ChenBaoW/Foot-wheel-robots/hardware/image/硬件讲解/1720327964392.png

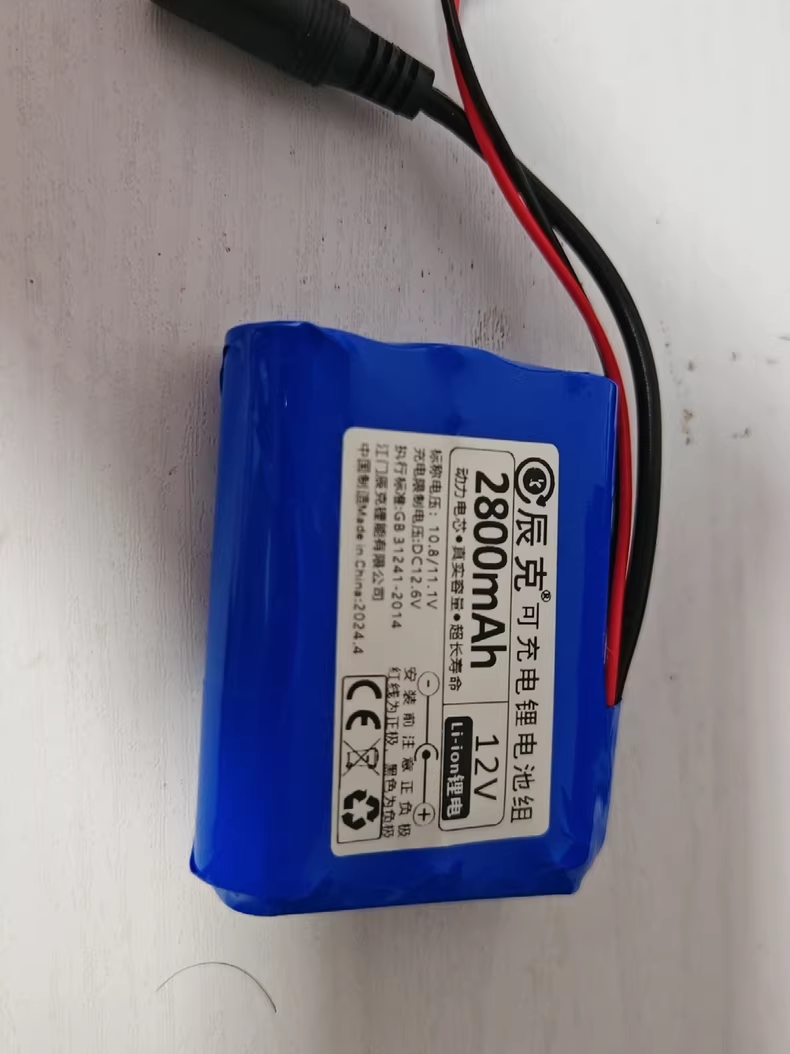
hardware/image/硬件讲解/1720327964392.png
