ChenBaoW/Foot-wheel-robots/mechanical structure/3D文件/镜向右小腿.step

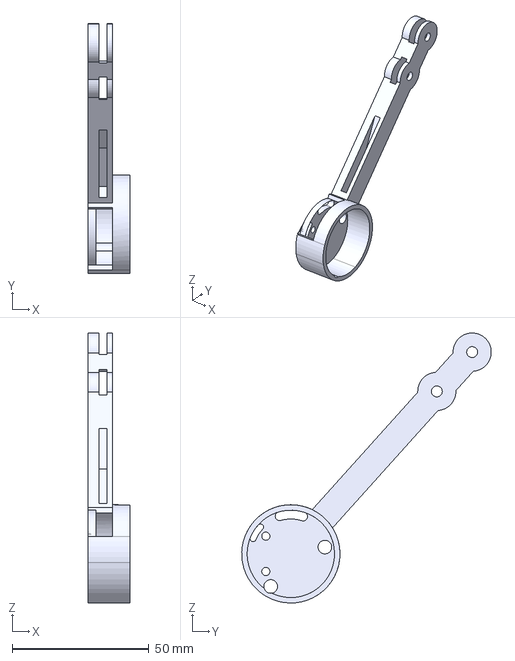
[picture p21: CAD file, 2024-07-05]
mechanical structure/3D文件/镜向右小腿.step
15.5 x 91.4 x 98.9 mm
