ChenBaoW/Foot-wheel-robots/mechanical structure/3D文件/大腿.step

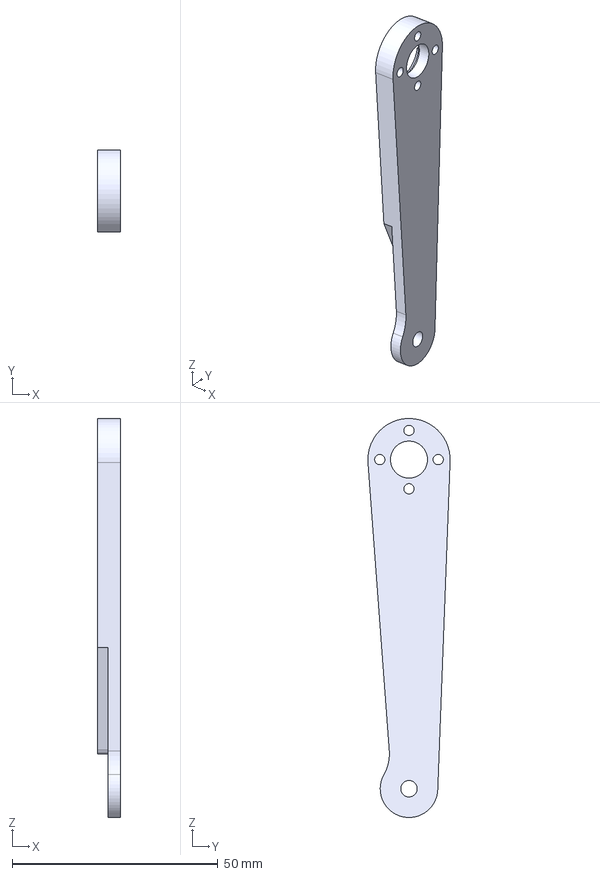
[picture p22: CAD file, 2024-07-05]
mechanical structure/3D文件/大腿.step
5.50 x 20.0 x 97.0 mm
