ChenBaoW/Foot-wheel-robots/mechanical structure/3D文件/镜向副腿.step

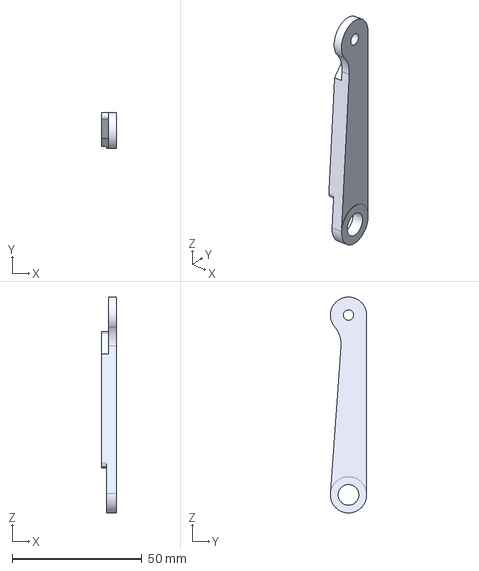
[picture p23: CAD file, 2024-07-05]
mechanical structure/3D文件/镜向副腿.step
5.95 x 14.0 x 83.4 mm
