ChenBaoW/Foot-wheel-robots/mechanical structure/3D文件/前支撑(带电池夹) .step

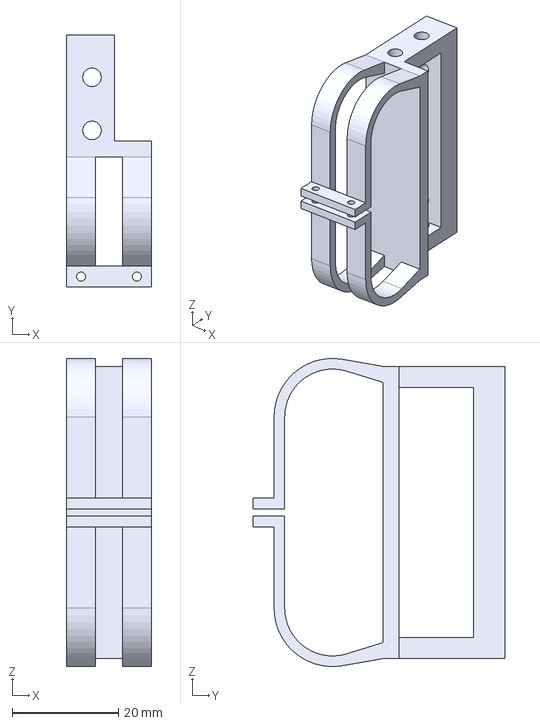
[picture p24: CAD file, 2024-07-05]
mechanical structure/3D文件/前支撑(带电池夹) .step
16.0 x 47.5 x 58.0 mm
