ChenBaoW/Foot-wheel-robots/mechanical structure/3D文件/后支撑.step

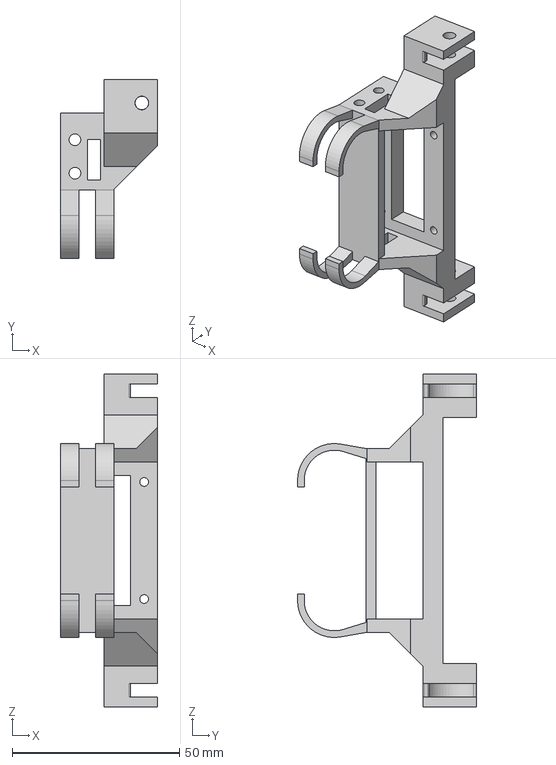
[picture p25: CAD file, 2024-07-05]
mechanical structure/3D文件/后支撑.step
29.0 x 53.5 x 99.6 mm
