ChenBaoW/Foot-wheel-robots/(list of files, cad)

Other CAD files:
mechanical structure/3D文件/副腿.step
mechanical structure/3D文件/镜向大腿.step
mechanical structure/3D文件/前支撑(带电池夹)_.f3d
mechanical structure/3D文件/副腿.f3d
mechanical structure/3D文件/右小腿.f3d
mechanical structure/3D文件/后支撑.f3d
mechanical structure/3D文件/后支撑.ipt
mechanical structure/3D文件/大腿.f3d
mechanical structure/3D文件/大腿.stl
mechanical structure/3D文件/镜向副腿.f3d
mechanical structure/3D文件/镜向右小腿.f3d
mechanical structure/3D文件/镜向大腿.f3d
