ChenBaoW/Foot-wheel-robots/software/4_closeloop_M1_test/4_closeloop_M1/Objects/motor.htm

# Static Call Graph for image .\Objects\motor.axf

#<CALLGRAPH># ARM Linker, 5060960: Last Updated: Thu Apr 11 21:01:33 2024

### Maximum Stack Usage = 352 bytes + Unknown(Cycles, Untraceable Function Pointers)

### Call chain for Maximum Stack Depth:

main ⇒ Motor_initFOC ⇒ alignSensor ⇒ setPhaseVoltage ⇒ atan2 ⇒ atan ⇒ __kernel_poly ⇒ __aeabi_dmul ⇒ _double_epilogue ⇒ _double_round

### Mutually Recursive functions

- ADC1_2_IRQHandler ⇒ ADC1_2_IRQHandler

### Function Pointers

- ADC1_2_IRQHandler from startup_stm32f10x_md.o(.text) referenced from startup_stm32f10x_md.o(RESET)
- BusFault_Handler from stm32f10x_it.o(i.BusFault_Handler) referenced from startup_stm32f10x_md.o(RESET)
- CAN1_RX1_IRQHandler from startup_stm32f10x_md.o(.text) referenced from startup_stm32f10x_md.o(RESET)
- CAN1_SCE_IRQHandler from startup_stm32f10x_md.o(.text) referenced from startup_stm32f10x_md.o(RESET)
- DMA1_Channel1_IRQHandler from startup_stm32f10x_md.o(.text) referenced from startup_stm32f10x_md.o(RESET)
- DMA1_Channel2_IRQHandler from startup_stm32f10x_md.o(.text) referenced from startup_stm32f10x_md.o(RESET)
- DMA1_Channel3_IRQHandler from startup_stm32f10x_md.o(.text) referenced from startup_stm32f10x_md.o(RESET)
- DMA1_Channel4_IRQHandler from startup_stm32f10x_md.o(.text) referenced from startup_stm32f10x_md.o(RESET)
- DMA1_Channel5_IRQHandler from startup_stm32f10x_md.o(.text) referenced from startup_stm32f10x_md.o(RESET)
- DMA1_Channel6_IRQHandler from startup_stm32f10x_md.o(.text) referenced from startup_stm32f10x_md.o(RESET)
- DMA1_Channel7_IRQHandler from startup_stm32f10x_md.o(.text) referenced from startup_stm32f10x_md.o(RESET)
- DebugMon_Handler from stm32f10x_it.o(i.DebugMon_Handler) referenced from startup_stm32f10x_md.o(RESET)
- EXTI0_IRQHandler from startup_stm32f10x_md.o(.text) referenced from startup_stm32f10x_md.o(RESET)
- EXTI15_10_IRQHandler from startup_stm32f10x_md.o(.text) referenced from startup_stm32f10x_md.o(RESET)
- EXTI1_IRQHandler from startup_stm32f10x_md.o(.text) referenced from startup_stm32f10x_md.o(RESET)
- EXTI2_IRQHandler from startup_stm32f10x_md.o(.text) referenced from startup_stm32f10x_md.o(RESET)
- EXTI3_IRQHandler from startup_stm32f10x_md.o(.text) referenced from startup_stm32f10x_md.o(RESET)
- EXTI4_IRQHandler from startup_stm32f10x_md.o(.text) referenced from startup_stm32f10x_md.o(RESET)
- EXTI9_5_IRQHandler from startup_stm32f10x_md.o(.text) referenced from startup_stm32f10x_md.o(RESET)
- FLASH_IRQHandler from startup_stm32f10x_md.o(.text) referenced from startup_stm32f10x_md.o(RESET)
- HardFault_Handler from stm32f10x_it.o(i.HardFault_Handler) referenced from startup_stm32f10x_md.o(RESET)
- I2C1_ER_IRQHandler from startup_stm32f10x_md.o(.text) referenced from startup_stm32f10x_md.o(RESET)
- I2C1_EV_IRQHandler from startup_stm32f10x_md.o(.text) referenced from startup_stm32f10x_md.o(RESET)
- I2C2_ER_IRQHandler from startup_stm32f10x_md.o(.text) referenced from startup_stm32f10x_md.o(RESET)
- I2C2_EV_IRQHandler from startup_stm32f10x_md.o(.text) referenced from startup_stm32f10x_md.o(RESET)
- MemManage_Handler from stm32f10x_it.o(i.MemManage_Handler) referenced from startup_stm32f10x_md.o(RESET)
- NMI_Handler from stm32f10x_it.o(i.NMI_Handler) referenced from startup_stm32f10x_md.o(RESET)
- PVD_IRQHandler from startup_stm32f10x_md.o(.text) referenced from startup_stm32f10x_md.o(RESET)
- PendSV_Handler from stm32f10x_it.o(i.PendSV_Handler) referenced from startup_stm32f10x_md.o(RESET)
- RCC_IRQHandler from startup_stm32f10x_md.o(.text) referenced from startup_stm32f10x_md.o(RESET)
- RTCAlarm_IRQHandler from startup_stm32f10x_md.o(.text) referenced from startup_stm32f10x_md.o(RESET)
- RTC_IRQHandler from startup_stm32f10x_md.o(.text) referenced from startup_stm32f10x_md.o(RESET)
- Reset_Handler from startup_stm32f10x_md.o(.text) referenced from startup_stm32f10x_md.o(RESET)
- SPI1_IRQHandler from startup_stm32f10x_md.o(.text) referenced from startup_stm32f10x_md.o(RESET)
- SPI2_IRQHandler from startup_stm32f10x_md.o(.text) referenced from startup_stm32f10x_md.o(RESET)
- SVC_Handler from stm32f10x_it.o(i.SVC_Handler) referenced from startup_stm32f10x_md.o(RESET)
- SysTick_Handler from stm32f10x_it.o(i.SysTick_Handler) referenced from startup_stm32f10x_md.o(RESET)
- SystemInit from system_stm32f10x.o(i.SystemInit) referenced from startup_stm32f10x_md.o(.text)
- TAMPER_IRQHandler from startup_stm32f10x_md.o(.text) referenced from startup_stm32f10x_md.o(RESET)
- TIM1_BRK_IRQHandler from startup_stm32f10x_md.o(.text) referenced from startup_stm32f10x_md.o(RESET)
- TIM1_CC_IRQHandler from startup_stm32f10x_md.o(.text) referenced from startup_stm32f10x_md.o(RESET)
- TIM1_TRG_COM_IRQHandler from startup_stm32f10x_md.o(.text) referenced from startup_stm32f10x_md.o(RESET)
- TIM1_UP_IRQHandler from startup_stm32f10x_md.o(.text) referenced from startup_stm32f10x_md.o(RESET)
- TIM2_IRQHandler from startup_stm32f10x_md.o(.text) referenced from startup_stm32f10x_md.o(RESET)
- TIM3_IRQHandler from startup_stm32f10x_md.o(.text) referenced from startup_stm32f10x_md.o(RESET)
- TIM4_IRQHandler from stm32f10x_it.o(i.TIM4_IRQHandler) referenced from startup_stm32f10x_md.o(RESET)
- USART1_IRQHandler from usart.o(i.USART1_IRQHandler) referenced from startup_stm32f10x_md.o(RESET)
- USART2_IRQHandler from startup_stm32f10x_md.o(.text) referenced from startup_stm32f10x_md.o(RESET)
- USART3_IRQHandler from startup_stm32f10x_md.o(.text) referenced from startup_stm32f10x_md.o(RESET)
- USBWakeUp_IRQHandler from startup_stm32f10x_md.o(.text) referenced from startup_stm32f10x_md.o(RESET)
- USB_HP_CAN1_TX_IRQHandler from startup_stm32f10x_md.o(.text) referenced from startup_stm32f10x_md.o(RESET)
- USB_LP_CAN1_RX0_IRQHandler from startup_stm32f10x_md.o(.text) referenced from startup_stm32f10x_md.o(RESET)
- UsageFault_Handler from stm32f10x_it.o(i.UsageFault_Handler) referenced from startup_stm32f10x_md.o(RESET)
- WWDG_IRQHandler from startup_stm32f10x_md.o(.text) referenced from startup_stm32f10x_md.o(RESET)
- __main from entry.o(.ARM.Collect$$$$00000000) referenced from startup_stm32f10x_md.o(.text)
- _sbackspace from _sgetc.o(.text) referenced from strtod.o(.text)
- _sgetc from _sgetc.o(.text) referenced from strtod.o(.text)
- fputc from usart.o(i.fputc) referenced from printfb.o(i.__0printf$bare)
- isspace from isspace_c.o(.text) referenced from strtod.o(.text)
- main from main.o(i.main) referenced from entry9a.o(.ARM.Collect$$$$0000000B)

### Global Symbols

__main (Thumb, 0 bytes, Stack size unknown bytes, entry.o(.ARM.Collect$$$$00000000))
[Address Reference Count : 1]

- startup_stm32f10x_md.o(.text)

_main_stk (Thumb, 0 bytes, Stack size unknown bytes, entry2.o(.ARM.Collect$$$$00000001))

_main_scatterload (Thumb, 0 bytes, Stack size unknown bytes, entry5.o(.ARM.Collect$$$$00000004))

[Calls]

- >> __scatterload

__main_after_scatterload (Thumb, 0 bytes, Stack size unknown bytes, entry5.o(.ARM.Collect$$$$00000004))

[Called By]

- >> __scatterload

_main_clock (Thumb, 0 bytes, Stack size unknown bytes, entry7b.o(.ARM.Collect$$$$00000008))

_main_cpp_init (Thumb, 0 bytes, Stack size unknown bytes, entry8b.o(.ARM.Collect$$$$0000000A))

_main_init (Thumb, 0 bytes, Stack size unknown bytes, entry9a.o(.ARM.Collect$$$$0000000B))

__rt_lib_shutdown_fini (Thumb, 0 bytes, Stack size unknown bytes, entry12b.o(.ARM.Collect$$$$0000000E))

__rt_final_cpp (Thumb, 0 bytes, Stack size unknown bytes, entry10a.o(.ARM.Collect$$$$0000000F))

__rt_final_exit (Thumb, 0 bytes, Stack size unknown bytes, entry11a.o(.ARM.Collect$$$$00000011))

Reset_Handler (Thumb, 8 bytes, Stack size 0 bytes, startup_stm32f10x_md.o(.text))
[Address Reference Count : 1]

- startup_stm32f10x_md.o(RESET)

ADC1_2_IRQHandler (Thumb, 0 bytes, Stack size 0 bytes, startup_stm32f10x_md.o(.text))

[Calls]

- >> ADC1_2_IRQHandler

[Called By]

- >> ADC1_2_IRQHandler

[Address Reference Count : 1]

- startup_stm32f10x_md.o(RESET)

CAN1_RX1_IRQHandler (Thumb, 0 bytes, Stack size 0 bytes, startup_stm32f10x_md.o(.text))
[Address Reference Count : 1]

- startup_stm32f10x_md.o(RESET)

CAN1_SCE_IRQHandler (Thumb, 0 bytes, Stack size 0 bytes, startup_stm32f10x_md.o(.text))
[Address Reference Count : 1]

- startup_stm32f10x_md.o(RESET)

DMA1_Channel1_IRQHandler (Thumb, 0 bytes, Stack size 0 bytes, startup_stm32f10x_md.o(.text))
[Address Reference Count : 1]

- startup_stm32f10x_md.o(RESET)

DMA1_Channel2_IRQHandler (Thumb, 0 bytes, Stack size 0 bytes, startup_stm32f10x_md.o(.text))
[Address Reference Count : 1]

- startup_stm32f10x_md.o(RESET)

DMA1_Channel3_IRQHandler (Thumb, 0 bytes, Stack size 0 bytes, startup_stm32f10x_md.o(.text))
[Address Reference Count : 1]

- startup_stm32f10x_md.o(RESET)

DMA1_Channel4_IRQHandler (Thumb, 0 bytes, Stack size 0 bytes, startup_stm32f10x_md.o(.text))
[Address Reference Count : 1]

- startup_stm32f10x_md.o(RESET)

DMA1_Channel5_IRQHandler (Thumb, 0 bytes, Stack size 0 bytes, startup_stm32f10x_md.o(.text))
[Address Reference Count : 1]

- startup_stm32f10x_md.o(RESET)

DMA1_Channel6_IRQHandler (Thumb, 0 bytes, Stack size 0 bytes, startup_stm32f10x_md.o(.text))
[Address Reference Count : 1]

- startup_stm32f10x_md.o(RESET)

DMA1_Channel7_IRQHandler (Thumb, 0 bytes, Stack size 0 bytes, startup_stm32f10x_md.o(.text))
[Address Reference Count : 1]

- startup_stm32f10x_md.o(RESET)

EXTI0_IRQHandler (Thumb, 0 bytes, Stack size 0 bytes, startup_stm32f10x_md.o(.text))
[Address Reference Count : 1]

- startup_stm32f10x_md.o(RESET)

EXTI15_10_IRQHandler (Thumb, 0 bytes, Stack size 0 bytes, startup_stm32f10x_md.o(.text))
[Address Reference Count : 1]

- startup_stm32f10x_md.o(RESET)

EXTI1_IRQHandler (Thumb, 0 bytes, Stack size 0 bytes, startup_stm32f10x_md.o(.text))
[Address Reference Count : 1]

- startup_stm32f10x_md.o(RESET)

EXTI2_IRQHandler (Thumb, 0 bytes, Stack size 0 bytes, startup_stm32f10x_md.o(.text))
[Address Reference Count : 1]

- startup_stm32f10x_md.o(RESET)

EXTI3_IRQHandler (Thumb, 0 bytes, Stack size 0 bytes, startup_stm32f10x_md.o(.text))
[Address Reference Count : 1]

- startup_stm32f10x_md.o(RESET)

EXTI4_IRQHandler (Thumb, 0 bytes, Stack size 0 bytes, startup_stm32f10x_md.o(.text))
[Address Reference Count : 1]

- startup_stm32f10x_md.o(RESET)

EXTI9_5_IRQHandler (Thumb, 0 bytes, Stack size 0 bytes, startup_stm32f10x_md.o(.text))
[Address Reference Count : 1]

- startup_stm32f10x_md.o(RESET)

FLASH_IRQHandler (Thumb, 0 bytes, Stack size 0 bytes, startup_stm32f10x_md.o(.text))
[Address Reference Count : 1]

- startup_stm32f10x_md.o(RESET)

I2C1_ER_IRQHandler (Thumb, 0 bytes, Stack size 0 bytes, startup_stm32f10x_md.o(.text))
[Address Reference Count : 1]

- startup_stm32f10x_md.o(RESET)

I2C1_EV_IRQHandler (Thumb, 0 bytes, Stack size 0 bytes, startup_stm32f10x_md.o(.text))
[Address Reference Count : 1]

- startup_stm32f10x_md.o(RESET)

I2C2_ER_IRQHandler (Thumb, 0 bytes, Stack size 0 bytes, startup_stm32f10x_md.o(.text))
[Address Reference Count : 1]

- startup_stm32f10x_md.o(RESET)

I2C2_EV_IRQHandler (Thumb, 0 bytes, Stack size 0 bytes, startup_stm32f10x_md.o(.text))
[Address Reference Count : 1]

- startup_stm32f10x_md.o(RESET)

PVD_IRQHandler (Thumb, 0 bytes, Stack size 0 bytes, startup_stm32f10x_md.o(.text))
[Address Reference Count : 1]

- startup_stm32f10x_md.o(RESET)

RCC_IRQHandler (Thumb, 0 bytes, Stack size 0 bytes, startup_stm32f10x_md.o(.text))
[Address Reference Count : 1]

- startup_stm32f10x_md.o(RESET)

RTCAlarm_IRQHandler (Thumb, 0 bytes, Stack size 0 bytes, startup_stm32f10x_md.o(.text))
[Address Reference Count : 1]

- startup_stm32f10x_md.o(RESET)

RTC_IRQHandler (Thumb, 0 bytes, Stack size 0 bytes, startup_stm32f10x_md.o(.text))
[Address Reference Count : 1]

- startup_stm32f10x_md.o(RESET)

SPI1_IRQHandler (Thumb, 0 bytes, Stack size 0 bytes, startup_stm32f10x_md.o(.text))
[Address Reference Count : 1]

- startup_stm32f10x_md.o(RESET)

SPI2_IRQHandler (Thumb, 0 bytes, Stack size 0 bytes, startup_stm32f10x_md.o(.text))
[Address Reference Count : 1]

- startup_stm32f10x_md.o(RESET)

TAMPER_IRQHandler (Thumb, 0 bytes, Stack size 0 bytes, startup_stm32f10x_md.o(.text))
[Address Reference Count : 1]

- startup_stm32f10x_md.o(RESET)

TIM1_BRK_IRQHandler (Thumb, 0 bytes, Stack size 0 bytes, startup_stm32f10x_md.o(.text))
[Address Reference Count : 1]

- startup_stm32f10x_md.o(RESET)

TIM1_CC_IRQHandler (Thumb, 0 bytes, Stack size 0 bytes, startup_stm32f10x_md.o(.text))
[Address Reference Count : 1]

- startup_stm32f10x_md.o(RESET)

TIM1_TRG_COM_IRQHandler (Thumb, 0 bytes, Stack size 0 bytes, startup_stm32f10x_md.o(.text))
[Address Reference Count : 1]

- startup_stm32f10x_md.o(RESET)

TIM1_UP_IRQHandler (Thumb, 0 bytes, Stack size 0 bytes, startup_stm32f10x_md.o(.text))
[Address Reference Count : 1]

- startup_stm32f10x_md.o(RESET)

TIM2_IRQHandler (Thumb, 0 bytes, Stack size 0 bytes, startup_stm32f10x_md.o(.text))
[Address Reference Count : 1]

- startup_stm32f10x_md.o(RESET)

TIM3_IRQHandler (Thumb, 0 bytes, Stack size 0 bytes, startup_stm32f10x_md.o(.text))
[Address Reference Count : 1]

- startup_stm32f10x_md.o(RESET)

USART2_IRQHandler (Thumb, 0 bytes, Stack size 0 bytes, startup_stm32f10x_md.o(.text))
[Address Reference Count : 1]

- startup_stm32f10x_md.o(RESET)

USART3_IRQHandler (Thumb, 0 bytes, Stack size 0 bytes, startup_stm32f10x_md.o(.text))
[Address Reference Count : 1]

- startup_stm32f10x_md.o(RESET)

USBWakeUp_IRQHandler (Thumb, 0 bytes, Stack size 0 bytes, startup_stm32f10x_md.o(.text))
[Address Reference Count : 1]

- startup_stm32f10x_md.o(RESET)

USB_HP_CAN1_TX_IRQHandler (Thumb, 0 bytes, Stack size 0 bytes, startup_stm32f10x_md.o(.text))
[Address Reference Count : 1]

- startup_stm32f10x_md.o(RESET)

USB_LP_CAN1_RX0_IRQHandler (Thumb, 0 bytes, Stack size 0 bytes, startup_stm32f10x_md.o(.text))
[Address Reference Count : 1]

- startup_stm32f10x_md.o(RESET)

WWDG_IRQHandler (Thumb, 0 bytes, Stack size 0 bytes, startup_stm32f10x_md.o(.text))
[Address Reference Count : 1]

- startup_stm32f10x_md.o(RESET)

__aeabi_fadd (Thumb, 164 bytes, Stack size 16 bytes, fadd.o(.text))

[Stack]

- Max Depth = 20
- Call Chain = __aeabi_fadd ⇒ _float_epilogue

[Calls]

- >> _float_round
- >> _float_epilogue

[Called By]

- >> __aeabi_frsub
- >> setPhaseVoltage
- >> __aeabi_fsub
- >> electricalAngle

__aeabi_fsub (Thumb, 6 bytes, Stack size 0 bytes, fadd.o(.text))

[Stack]

- Max Depth = 20
- Call Chain = __aeabi_fsub ⇒ __aeabi_fadd ⇒ _float_epilogue

[Calls]

- >> __aeabi_fadd

[Called By]

- >> setPhaseVoltage
- >> getVelocity
- >> shaftAngle
- >> electricalAngle

__aeabi_frsub (Thumb, 6 bytes, Stack size 0 bytes, fadd.o(.text))

[Stack]

- Max Depth = 20
- Call Chain = __aeabi_frsub ⇒ __aeabi_fadd ⇒ _float_epilogue

[Calls]

- >> __aeabi_fadd

[Called By]

- >> getAngle

__aeabi_fmul (Thumb, 100 bytes, Stack size 8 bytes, fmul.o(.text))

[Stack]

- Max Depth = 8
- Call Chain = __aeabi_fmul

[Called By]

- >> setPhaseVoltage
- >> alignSensor
- >> shaftVelocity
- >> shaftAngle
- >> electricalAngle
- >> _sqrtApprox
- >> _electricalAngle

__aeabi_fdiv (Thumb, 124 bytes, Stack size 8 bytes, fdiv.o(.text))

[Stack]

- Max Depth = 8
- Call Chain = __aeabi_fdiv

[Calls]

- >> _float_round

[Called By]

- >> setPhaseVoltage
- >> getVelocity
- >> getAngle

__aeabi_dadd (Thumb, 322 bytes, Stack size 48 bytes, dadd.o(.text))

[Stack]

- Max Depth = 88
- Call Chain = __aeabi_dadd ⇒ _double_epilogue ⇒ _double_round

[Calls]

- >> __aeabi_lasr
- >> __aeabi_llsl
- >> _double_round
- >> _double_epilogue

[Called By]

- >> __aeabi_drsub
- >> setPhaseVoltage
- >> getAngle
- >> LPF_velocity
- >> __aeabi_dsub
- >> _sin
- >> _normalizeAngle
- >> __kernel_poly
- >> __mathlib_dbl_infnan2
- >> atan

__aeabi_dsub (Thumb, 6 bytes, Stack size 0 bytes, dadd.o(.text))

[Stack]

- Max Depth = 88
- Call Chain = __aeabi_dsub ⇒ __aeabi_dadd ⇒ _double_epilogue ⇒ _double_round

[Calls]

- >> __aeabi_dadd

[Called By]

- >> atan2
- >> setPhaseVoltage
- >> _sin
- >> atan

__aeabi_drsub (Thumb, 6 bytes, Stack size 0 bytes, dadd.o(.text))

[Stack]

- Max Depth = 88
- Call Chain = __aeabi_drsub ⇒ __aeabi_dadd ⇒ _double_epilogue ⇒ _double_round

[Calls]

- >> __aeabi_dadd

[Called By]

- >> fmod
- >> atan2
- >> atan

__aeabi_dmul (Thumb, 228 bytes, Stack size 48 bytes, dmul.o(.text))

[Stack]

- Max Depth = 88
- Call Chain = __aeabi_dmul ⇒ _double_epilogue ⇒ _double_round

[Calls]

- >> _double_epilogue

[Called By]

- >> setPhaseVoltage
- >> getVelocity
- >> getAngle
- >> LPF_velocity
- >> _sin
- >> _fp_value
- >> __kernel_poly
- >> atan

__aeabi_ddiv (Thumb, 222 bytes, Stack size 32 bytes, ddiv.o(.text))

[Stack]

- Max Depth = 40
- Call Chain = __aeabi_ddiv ⇒ _double_round

[Calls]

- >> _double_round

[Called By]

- >> atan2
- >> setPhaseVoltage
- >> _fp_value
- >> __mathlib_dbl_invalid
- >> atan

__aeabi_i2f (Thumb, 18 bytes, Stack size 0 bytes, fflti.o(.text))

[Stack]

- Max Depth = 4
- Call Chain = __aeabi_i2f ⇒ _float_epilogue

[Calls]

- >> _float_epilogue

[Called By]

- >> alignSensor
- >> getAngle
- >> shaftVelocity
- >> shaftAngle
- >> electricalAngle
- >> _electricalAngle

__aeabi_ui2f (Thumb, 10 bytes, Stack size 0 bytes, ffltui.o(.text))

[Stack]

- Max Depth = 4
- Call Chain = __aeabi_ui2f ⇒ _float_epilogue

[Calls]

- >> _float_epilogue

[Called By]

- >> getVelocity
- >> getAngle

__aeabi_i2d (Thumb, 34 bytes, Stack size 16 bytes, dflti.o(.text))

[Stack]

- Max Depth = 56
- Call Chain = __aeabi_i2d ⇒ _double_epilogue ⇒ _double_round

[Calls]

- >> _double_epilogue

[Called By]

- >> getAngle
- >> _sin

__aeabi_ui2d (Thumb, 26 bytes, Stack size 16 bytes, dfltui.o(.text))

[Stack]

- Max Depth = 56
- Call Chain = __aeabi_ui2d ⇒ _double_epilogue ⇒ _double_round

[Calls]

- >> _double_epilogue

[Called By]

- >> setPhaseVoltage

__aeabi_f2iz (Thumb, 50 bytes, Stack size 0 bytes, ffixi.o(.text))

[Called By]

- >> getAngle

__aeabi_f2uiz (Thumb, 40 bytes, Stack size 0 bytes, ffixui.o(.text))

[Called By]

- >> setPhaseVoltage

__aeabi_d2iz (Thumb, 62 bytes, Stack size 16 bytes, dfixi.o(.text))

[Stack]

- Max Depth = 16
- Call Chain = __aeabi_d2iz

[Calls]

- >> __aeabi_llsr

[Called By]

- >> _sin

__aeabi_d2uiz (Thumb, 50 bytes, Stack size 8 bytes, dfixui.o(.text))

[Stack]

- Max Depth = 8
- Call Chain = __aeabi_d2uiz

[Calls]

- >> __aeabi_llsr

[Called By]

- >> setPhaseVoltage

__aeabi_f2d (Thumb, 38 bytes, Stack size 0 bytes, f2d.o(.text))

[Called By]

- >> setPhaseVoltage
- >> getVelocity
- >> getAngle
- >> LPF_velocity
- >> _sin
- >> _normalizeAngle

__aeabi_cdcmpeq (Thumb, 0 bytes, Stack size 0 bytes, cdcmple.o(.text))

[Called By]

- >> atan2

__aeabi_cdcmple (Thumb, 48 bytes, Stack size 0 bytes, cdcmple.o(.text))

[Called By]

- >> setPhaseVoltage
- >> _sin

__aeabi_cdrcmple (Thumb, 48 bytes, Stack size 0 bytes, cdrcmple.o(.text))

[Called By]

- >> setPhaseVoltage
- >> getVelocity
- >> getAngle
- >> _sin

__aeabi_d2f (Thumb, 56 bytes, Stack size 8 bytes, d2f.o(.text))

[Stack]

- Max Depth = 8
- Call Chain = __aeabi_d2f

[Calls]

- >> _float_round

[Called By]

- >> commander_run
- >> setPhaseVoltage
- >> getVelocity
- >> getAngle
- >> LPF_velocity
- >> _sin
- >> _normalizeAngle
- >> _scanf_really_real

__aeabi_cfcmpeq (Thumb, 0 bytes, Stack size 0 bytes, cfcmple.o(.text))

[Called By]

- >> setPhaseVoltage
- >> getVelocity

__aeabi_cfcmple (Thumb, 20 bytes, Stack size 0 bytes, cfcmple.o(.text), UNUSED)

__aeabi_cfrcmple (Thumb, 20 bytes, Stack size 0 bytes, cfrcmple.o(.text))

[Called By]

- >> Motor_init
- >> getAngle
- >> _normalizeAngle

__aeabi_llsl (Thumb, 30 bytes, Stack size 0 bytes, llshl.o(.text))

[Called By]

- >> __aeabi_dadd
- >> _double_epilogue

_ll_shift_l (Thumb, 0 bytes, Stack size 0 bytes, llshl.o(.text), UNUSED)

__aeabi_llsr (Thumb, 32 bytes, Stack size 0 bytes, llushr.o(.text))

[Called By]

- >> __aeabi_d2uiz
- >> __aeabi_d2iz
- >> _double_epilogue

_ll_ushift_r (Thumb, 0 bytes, Stack size 0 bytes, llushr.o(.text), UNUSED)

__aeabi_lasr (Thumb, 36 bytes, Stack size 0 bytes, llsshr.o(.text))

[Called By]

- >> __aeabi_dadd

_ll_sshift_r (Thumb, 0 bytes, Stack size 0 bytes, llsshr.o(.text), UNUSED)

__strtod_int (Thumb, 90 bytes, Stack size 40 bytes, strtod.o(.text))

[Stack]

- Max Depth = 200
- Call Chain = __strtod_int ⇒ _local_sscanf ⇒ _scanf_real

[Calls]

- >> _local_sscanf

[Called By]

- >> atof

__I$use$fp (Thumb, 0 bytes, Stack size 0 bytes, iusefp.o(.text), UNUSED)

_float_round (Thumb, 18 bytes, Stack size 0 bytes, fepilogue.o(.text))

[Called By]

- >> __aeabi_fdiv
- >> __aeabi_fadd
- >> __aeabi_d2f

_float_epilogue (Thumb, 92 bytes, Stack size 4 bytes, fepilogue.o(.text))

[Stack]

- Max Depth = 4
- Call Chain = _float_epilogue

[Called By]

- >> __aeabi_ui2f
- >> __aeabi_fadd
- >> __aeabi_i2f

_double_round (Thumb, 30 bytes, Stack size 8 bytes, depilogue.o(.text))

[Stack]

- Max Depth = 8
- Call Chain = _double_round

[Called By]

- >> __aeabi_ddiv
- >> __aeabi_dadd
- >> _double_epilogue

_double_epilogue (Thumb, 156 bytes, Stack size 32 bytes, depilogue.o(.text))

[Stack]

- Max Depth = 40
- Call Chain = _double_epilogue ⇒ _double_round

[Calls]

- >> __aeabi_llsr
- >> __aeabi_llsl
- >> _double_round

[Called By]

- >> _drem
- >> __aeabi_ui2d
- >> __aeabi_i2d
- >> __aeabi_dmul
- >> __aeabi_dadd
- >> __aeabi_ul2d

_drem (Thumb, 134 bytes, Stack size 48 bytes, drem.o(.text))

[Stack]

- Max Depth = 88
- Call Chain = _drem ⇒ _double_epilogue ⇒ _double_round

[Calls]

- >> _double_epilogue

[Called By]

- >> fmod

__scatterload (Thumb, 28 bytes, Stack size 0 bytes, init.o(.text))

[Calls]

- >> __main_after_scatterload

[Called By]

- >> _main_scatterload

__scatterload_rt2 (Thumb, 0 bytes, Stack size 0 bytes, init.o(.text), UNUSED)

isspace (Thumb, 10 bytes, Stack size 0 bytes, isspace_c.o(.text))

[Calls]

- >> __ctype_lookup

[Address Reference Count : 1]

- strtod.o(.text)

_scanf_real (Thumb, 0 bytes, Stack size 104 bytes, scanf_fp.o(.text))

[Stack]

- Max Depth = 104
- Call Chain = _scanf_real

[Called By]

- >> _local_sscanf

_scanf_really_real (Thumb, 556 bytes, Stack size 104 bytes, scanf_fp.o(.text), UNUSED)

[Calls]

- >> __aeabi_d2f
- >> _is_digit
- >> _fp_value

_sgetc (Thumb, 30 bytes, Stack size 0 bytes, _sgetc.o(.text))
[Address Reference Count : 1]

- strtod.o(.text)

_sbackspace (Thumb, 34 bytes, Stack size 0 bytes, _sgetc.o(.text))
[Address Reference Count : 1]

- strtod.o(.text)

__ARM_scalbn (Thumb, 46 bytes, Stack size 16 bytes, dscalb.o(.text))

[Stack]

- Max Depth = 16
- Call Chain = __ARM_scalbn

[Called By]

- >> __mathlib_dbl_underflow
- >> __mathlib_dbl_infnan
- >> atan

scalbn (Thumb, 0 bytes, Stack size 16 bytes, dscalb.o(.text), UNUSED)

__ctype_lookup (Thumb, 34 bytes, Stack size 0 bytes, ctype_c.o(.text))

[Called By]

- >> isspace

__aeabi_ul2d (Thumb, 24 bytes, Stack size 16 bytes, dfltul.o(.text), UNUSED)

[Calls]

- >> _double_epilogue

[Called By]

- >> _fp_value

BusFault_Handler (Thumb, 4 bytes, Stack size 0 bytes, stm32f10x_it.o(i.BusFault_Handler))
[Address Reference Count : 1]

- startup_stm32f10x_md.o(RESET)

DebugMon_Handler (Thumb, 2 bytes, Stack size 0 bytes, stm32f10x_it.o(i.DebugMon_Handler))
[Address Reference Count : 1]

- startup_stm32f10x_md.o(RESET)

GPIO_Config (Thumb, 96 bytes, Stack size 8 bytes, main.o(i.GPIO_Config))

[Stack]

- Max Depth = 32
- Call Chain = GPIO_Config ⇒ GPIO_Init

[Calls]

- >> GPIO_ResetBits
- >> GPIO_PinRemapConfig
- >> GPIO_Init
- >> RCC_APB2PeriphClockCmd

[Called By]

- >> main

GPIO_Init (Thumb, 278 bytes, Stack size 24 bytes, stm32f10x_gpio.o(i.GPIO_Init))

[Stack]

- Max Depth = 24
- Call Chain = GPIO_Init

[Called By]

- >> GPIO_Config
- >> I2C_Init_
- >> uart_init
- >> TIM2_PWM_Init

GPIO_PinRemapConfig (Thumb, 138 bytes, Stack size 20 bytes, stm32f10x_gpio.o(i.GPIO_PinRemapConfig))

[Stack]

- Max Depth = 20
- Call Chain = GPIO_PinRemapConfig

[Called By]

- >> GPIO_Config

GPIO_ResetBits (Thumb, 4 bytes, Stack size 0 bytes, stm32f10x_gpio.o(i.GPIO_ResetBits))

[Called By]

- >> commander_run
- >> GPIO_Config

GPIO_SetBits (Thumb, 4 bytes, Stack size 0 bytes, stm32f10x_gpio.o(i.GPIO_SetBits))

[Called By]

- >> main
- >> commander_run
- >> Motor_init

HardFault_Handler (Thumb, 4 bytes, Stack size 0 bytes, stm32f10x_it.o(i.HardFault_Handler))
[Address Reference Count : 1]

- startup_stm32f10x_md.o(RESET)

I2C_Cmd (Thumb, 24 bytes, Stack size 0 bytes, stm32f10x_i2c.o(i.I2C_Cmd))

[Called By]

- >> I2C_Init_

I2C_DeInit (Thumb, 50 bytes, Stack size 8 bytes, stm32f10x_i2c.o(i.I2C_DeInit))

[Stack]

- Max Depth = 8
- Call Chain = I2C_DeInit

[Calls]

- >> RCC_APB1PeriphResetCmd

[Called By]

- >> I2C_Init_

I2C_GenerateSTOP (Thumb, 24 bytes, Stack size 0 bytes, stm32f10x_i2c.o(i.I2C_GenerateSTOP))

[Called By]

- >> I2C_getRawCount

I2C_Init (Thumb, 222 bytes, Stack size 48 bytes, stm32f10x_i2c.o(i.I2C_Init))

[Stack]

- Max Depth = 60
- Call Chain = I2C_Init ⇒ RCC_GetClocksFreq

[Calls]

- >> RCC_GetClocksFreq

[Called By]

- >> I2C_Init_

I2C_Init_ (Thumb, 110 bytes, Stack size 24 bytes, iic.o(i.I2C_Init_))

[Stack]

- Max Depth = 84
- Call Chain = I2C_Init_ ⇒ I2C_Init ⇒ RCC_GetClocksFreq

[Calls]

- >> I2C_Init
- >> I2C_DeInit
- >> I2C_Cmd
- >> GPIO_Init
- >> RCC_APB2PeriphClockCmd
- >> RCC_APB1PeriphClockCmd

[Called By]

- >> main

I2C_getRawCount (Thumb, 256 bytes, Stack size 24 bytes, magneticsensor.o(i.I2C_getRawCount))

[Stack]

- Max Depth = 24
- Call Chain = I2C_getRawCount

[Calls]

- >> I2C_GenerateSTOP

[Called By]

- >> MagneticSensor_Init
- >> getAngle

LPF_velocity (Thumb, 74 bytes, Stack size 48 bytes, lowpass_filter.o(i.LPF_velocity))

[Stack]

- Max Depth = 136
- Call Chain = LPF_velocity ⇒ __aeabi_dmul ⇒ _double_epilogue ⇒ _double_round

[Calls]

- >> __aeabi_f2d
- >> __aeabi_dmul
- >> __aeabi_dadd
- >> __aeabi_d2f

[Called By]

- >> shaftVelocity

MagneticSensor_Init (Thumb, 32 bytes, Stack size 8 bytes, magneticsensor.o(i.MagneticSensor_Init))

[Stack]

- Max Depth = 32
- Call Chain = MagneticSensor_Init ⇒ I2C_getRawCount

[Calls]

- >> I2C_getRawCount

[Called By]

- >> main

MemManage_Handler (Thumb, 4 bytes, Stack size 0 bytes, stm32f10x_it.o(i.MemManage_Handler))
[Address Reference Count : 1]

- startup_stm32f10x_md.o(RESET)

Motor_init (Thumb, 42 bytes, Stack size 8 bytes, bldcmotor.o(i.Motor_init))

[Stack]

- Max Depth = 8
- Call Chain = Motor_init

[Calls]

- >> GPIO_SetBits
- >> __aeabi_cfrcmple

[Called By]

- >> main

Motor_initFOC (Thumb, 66 bytes, Stack size 8 bytes, bldcmotor.o(i.Motor_initFOC))

[Stack]

- Max Depth = 352
- Call Chain = Motor_initFOC ⇒ alignSensor ⇒ setPhaseVoltage ⇒ atan2 ⇒ atan ⇒ __kernel_poly ⇒ __aeabi_dmul ⇒ _double_epilogue ⇒ _double_round

[Calls]

- >> alignSensor
- >> getAngle
- >> shaftVelocity
- >> shaftAngle
- >> delay_ms

[Called By]

- >> main

NMI_Handler (Thumb, 2 bytes, Stack size 0 bytes, stm32f10x_it.o(i.NMI_Handler))
[Address Reference Count : 1]

- startup_stm32f10x_md.o(RESET)

NVIC_Init (Thumb, 100 bytes, Stack size 16 bytes, misc.o(i.NVIC_Init))

[Stack]

- Max Depth = 16
- Call Chain = NVIC_Init

[Called By]

- >> uart_init
- >> TIM4_1ms_Init

PendSV_Handler (Thumb, 2 bytes, Stack size 0 bytes, stm32f10x_it.o(i.PendSV_Handler))
[Address Reference Count : 1]

- startup_stm32f10x_md.o(RESET)

RCC_APB1PeriphClockCmd (Thumb, 26 bytes, Stack size 0 bytes, stm32f10x_rcc.o(i.RCC_APB1PeriphClockCmd))

[Called By]

- >> I2C_Init_
- >> TIM4_1ms_Init
- >> TIM2_PWM_Init

RCC_APB1PeriphResetCmd (Thumb, 26 bytes, Stack size 0 bytes, stm32f10x_rcc.o(i.RCC_APB1PeriphResetCmd))

[Called By]

- >> I2C_DeInit
- >> TIM_DeInit

RCC_APB2PeriphClockCmd (Thumb, 26 bytes, Stack size 0 bytes, stm32f10x_rcc.o(i.RCC_APB2PeriphClockCmd))

[Called By]

- >> GPIO_Config
- >> I2C_Init_
- >> uart_init
- >> TIM2_PWM_Init

RCC_APB2PeriphResetCmd (Thumb, 26 bytes, Stack size 0 bytes, stm32f10x_rcc.o(i.RCC_APB2PeriphResetCmd))

[Called By]

- >> TIM_DeInit

RCC_GetClocksFreq (Thumb, 192 bytes, Stack size 12 bytes, stm32f10x_rcc.o(i.RCC_GetClocksFreq))

[Stack]

- Max Depth = 12
- Call Chain = RCC_GetClocksFreq

[Called By]

- >> I2C_Init
- >> USART_Init

SVC_Handler (Thumb, 2 bytes, Stack size 0 bytes, stm32f10x_it.o(i.SVC_Handler))
[Address Reference Count : 1]

- startup_stm32f10x_md.o(RESET)

SysTick_Handler (Thumb, 2 bytes, Stack size 0 bytes, stm32f10x_it.o(i.SysTick_Handler))
[Address Reference Count : 1]

- startup_stm32f10x_md.o(RESET)

SystemInit (Thumb, 78 bytes, Stack size 8 bytes, system_stm32f10x.o(i.SystemInit))

[Stack]

- Max Depth = 28
- Call Chain = SystemInit ⇒ SetSysClock ⇒ SetSysClockTo72

[Calls]

- >> SetSysClock

[Address Reference Count : 1]

- startup_stm32f10x_md.o(.text)

TIM2_PWM_Init (Thumb, 186 bytes, Stack size 40 bytes, timer.o(i.TIM2_PWM_Init))

[Stack]

- Max Depth = 64
- Call Chain = TIM2_PWM_Init ⇒ GPIO_Init

[Calls]

- >> GPIO_Init
- >> RCC_APB2PeriphClockCmd
- >> RCC_APB1PeriphClockCmd
- >> TIM_TimeBaseInit
- >> TIM_OC3PreloadConfig
- >> TIM_OC3Init
- >> TIM_OC2PreloadConfig
- >> TIM_OC2Init
- >> TIM_OC1PreloadConfig
- >> TIM_OC1Init
- >> TIM_DeInit
- >> TIM_Cmd
- >> TIM_ARRPreloadConfig

[Called By]

- >> main

TIM4_1ms_Init (Thumb, 80 bytes, Stack size 24 bytes, timer.o(i.TIM4_1ms_Init))

[Stack]

- Max Depth = 40
- Call Chain = TIM4_1ms_Init ⇒ NVIC_Init

[Calls]

- >> NVIC_Init
- >> RCC_APB1PeriphClockCmd
- >> TIM_TimeBaseInit
- >> TIM_ITConfig
- >> TIM_Cmd

[Called By]

- >> main

TIM4_IRQHandler (Thumb, 44 bytes, Stack size 8 bytes, stm32f10x_it.o(i.TIM4_IRQHandler))

[Stack]

- Max Depth = 20
- Call Chain = TIM4_IRQHandler ⇒ TIM_GetITStatus

[Calls]

- >> TIM_GetITStatus
- >> TIM_ClearITPendingBit

[Address Reference Count : 1]

- startup_stm32f10x_md.o(RESET)

TIM_ARRPreloadConfig (Thumb, 24 bytes, Stack size 0 bytes, stm32f10x_tim.o(i.TIM_ARRPreloadConfig))

[Called By]

- >> TIM2_PWM_Init

TIM_ClearITPendingBit (Thumb, 6 bytes, Stack size 0 bytes, stm32f10x_tim.o(i.TIM_ClearITPendingBit))

[Called By]

- >> TIM4_IRQHandler

TIM_Cmd (Thumb, 24 bytes, Stack size 0 bytes, stm32f10x_tim.o(i.TIM_Cmd))

[Called By]

- >> TIM4_1ms_Init
- >> TIM2_PWM_Init

TIM_DeInit (Thumb, 424 bytes, Stack size 8 bytes, stm32f10x_tim.o(i.TIM_DeInit))

[Stack]

- Max Depth = 8
- Call Chain = TIM_DeInit

[Calls]

- >> RCC_APB1PeriphResetCmd
- >> RCC_APB2PeriphResetCmd

[Called By]

- >> TIM2_PWM_Init

TIM_GetITStatus (Thumb, 34 bytes, Stack size 12 bytes, stm32f10x_tim.o(i.TIM_GetITStatus))

[Stack]

- Max Depth = 12
- Call Chain = TIM_GetITStatus

[Called By]

- >> TIM4_IRQHandler

TIM_ITConfig (Thumb, 18 bytes, Stack size 0 bytes, stm32f10x_tim.o(i.TIM_ITConfig))

[Called By]

- >> TIM4_1ms_Init

TIM_OC1Init (Thumb, 132 bytes, Stack size 16 bytes, stm32f10x_tim.o(i.TIM_OC1Init))

[Stack]

- Max Depth = 16
- Call Chain = TIM_OC1Init

[Called By]

- >> TIM2_PWM_Init

TIM_OC1PreloadConfig (Thumb, 18 bytes, Stack size 0 bytes, stm32f10x_tim.o(i.TIM_OC1PreloadConfig))

[Called By]

- >> TIM2_PWM_Init

TIM_OC2Init (Thumb, 154 bytes, Stack size 16 bytes, stm32f10x_tim.o(i.TIM_OC2Init))

[Stack]

- Max Depth = 16
- Call Chain = TIM_OC2Init

[Called By]

- >> TIM2_PWM_Init

TIM_OC2PreloadConfig (Thumb, 26 bytes, Stack size 0 bytes, stm32f10x_tim.o(i.TIM_OC2PreloadConfig))

[Called By]

- >> TIM2_PWM_Init

TIM_OC3Init (Thumb, 150 bytes, Stack size 16 bytes, stm32f10x_tim.o(i.TIM_OC3Init))

[Stack]

- Max Depth = 16
- Call Chain = TIM_OC3Init

[Called By]

- >> TIM2_PWM_Init

TIM_OC3PreloadConfig (Thumb, 18 bytes, Stack size 0 bytes, stm32f10x_tim.o(i.TIM_OC3PreloadConfig))

[Called By]

- >> TIM2_PWM_Init

TIM_SetCompare1 (Thumb, 4 bytes, Stack size 0 bytes, stm32f10x_tim.o(i.TIM_SetCompare1))

[Called By]

- >> setPhaseVoltage

TIM_SetCompare2 (Thumb, 4 bytes, Stack size 0 bytes, stm32f10x_tim.o(i.TIM_SetCompare2))

[Called By]

- >> setPhaseVoltage

TIM_SetCompare3 (Thumb, 4 bytes, Stack size 0 bytes, stm32f10x_tim.o(i.TIM_SetCompare3))

[Called By]

- >> setPhaseVoltage

TIM_TimeBaseInit (Thumb, 122 bytes, Stack size 0 bytes, stm32f10x_tim.o(i.TIM_TimeBaseInit))

[Called By]

- >> TIM4_1ms_Init
- >> TIM2_PWM_Init

USART1_IRQHandler (Thumb, 136 bytes, Stack size 8 bytes, usart.o(i.USART1_IRQHandler))

[Stack]

- Max Depth = 24
- Call Chain = USART1_IRQHandler ⇒ USART_GetITStatus

[Calls]

- >> USART_ReceiveData
- >> USART_GetITStatus

[Address Reference Count : 1]

- startup_stm32f10x_md.o(RESET)

USART_Cmd (Thumb, 24 bytes, Stack size 0 bytes, stm32f10x_usart.o(i.USART_Cmd))

[Called By]

- >> uart_init

USART_GetITStatus (Thumb, 84 bytes, Stack size 16 bytes, stm32f10x_usart.o(i.USART_GetITStatus))

[Stack]

- Max Depth = 16
- Call Chain = USART_GetITStatus

[Called By]

- >> USART1_IRQHandler

USART_ITConfig (Thumb, 74 bytes, Stack size 20 bytes, stm32f10x_usart.o(i.USART_ITConfig))

[Stack]

- Max Depth = 20
- Call Chain = USART_ITConfig

[Called By]

- >> uart_init

USART_Init (Thumb, 210 bytes, Stack size 56 bytes, stm32f10x_usart.o(i.USART_Init))

[Stack]

- Max Depth = 68
- Call Chain = USART_Init ⇒ RCC_GetClocksFreq

[Calls]

- >> RCC_GetClocksFreq

[Called By]

- >> uart_init

USART_ReceiveData (Thumb, 10 bytes, Stack size 0 bytes, stm32f10x_usart.o(i.USART_ReceiveData))

[Called By]

- >> USART1_IRQHandler

UsageFault_Handler (Thumb, 4 bytes, Stack size 0 bytes, stm32f10x_it.o(i.UsageFault_Handler))
[Address Reference Count : 1]

- startup_stm32f10x_md.o(RESET)

__0printf$bare (Thumb, 8 bytes, Stack size 0 bytes, printfb.o(i.__0printf$bare), UNUSED)

[Calls]

- >> _printf_core

__1printf$bare (Thumb, 0 bytes, Stack size 0 bytes, printfb.o(i.__0printf$bare), UNUSED)

__2printf (Thumb, 0 bytes, Stack size 0 bytes, printfb.o(i.__0printf$bare))

[Called By]

- >> commander_run

__ARM_fpclassify (Thumb, 40 bytes, Stack size 0 bytes, fpclassify.o(i.__ARM_fpclassify))

[Called By]

- >> atan

__kernel_poly (Thumb, 170 bytes, Stack size 24 bytes, poly.o(i.__kernel_poly))

[Stack]

- Max Depth = 112
- Call Chain = __kernel_poly ⇒ __aeabi_dmul ⇒ _double_epilogue ⇒ _double_round

[Calls]

- >> __aeabi_dmul
- >> __aeabi_dadd

[Called By]

- >> atan

__mathlib_dbl_infnan (Thumb, 6 bytes, Stack size 0 bytes, dunder.o(i.__mathlib_dbl_infnan))

[Stack]

- Max Depth = 16
- Call Chain = __mathlib_dbl_infnan ⇒ __ARM_scalbn

[Calls]

- >> __ARM_scalbn

[Called By]

- >> atan

__mathlib_dbl_infnan2 (Thumb, 4 bytes, Stack size 0 bytes, dunder.o(i.__mathlib_dbl_infnan2))

[Stack]

- Max Depth = 88
- Call Chain = __mathlib_dbl_infnan2 ⇒ __aeabi_dadd ⇒ _double_epilogue ⇒ _double_round

[Calls]

- >> __aeabi_dadd

[Called By]

- >> atan2

__mathlib_dbl_invalid (Thumb, 12 bytes, Stack size 0 bytes, dunder.o(i.__mathlib_dbl_invalid))

[Stack]

- Max Depth = 40
- Call Chain = __mathlib_dbl_invalid ⇒ __aeabi_ddiv ⇒ _double_round

[Calls]

- >> __aeabi_ddiv

[Called By]

- >> fmod

__mathlib_dbl_underflow (Thumb, 10 bytes, Stack size 0 bytes, dunder.o(i.__mathlib_dbl_underflow))

[Stack]

- Max Depth = 16
- Call Chain = __mathlib_dbl_underflow ⇒ __ARM_scalbn

[Calls]

- >> __ARM_scalbn

[Called By]

- >> atan

__read_errno (Thumb, 6 bytes, Stack size 0 bytes, errno.o(i.__read_errno))

[Called By]

- >> atof

__scatterload_copy (Thumb, 14 bytes, Stack size unknown bytes, handlers.o(i.__scatterload_copy), UNUSED)

__scatterload_null (Thumb, 2 bytes, Stack size unknown bytes, handlers.o(i.__scatterload_null), UNUSED)

__scatterload_zeroinit (Thumb, 14 bytes, Stack size unknown bytes, handlers.o(i.__scatterload_zeroinit), UNUSED)

__set_errno (Thumb, 6 bytes, Stack size 0 bytes, errno.o(i.__set_errno))

[Called By]

- >> fmod
- >> atof
- >> atan2

_electricalAngle (Thumb, 22 bytes, Stack size 16 bytes, foc_utils.o(i._electricalAngle))

[Stack]

- Max Depth = 24
- Call Chain = _electricalAngle ⇒ __aeabi_fmul

[Calls]

- >> __aeabi_i2f
- >> __aeabi_fmul

[Called By]

- >> alignSensor

_is_digit (Thumb, 14 bytes, Stack size 0 bytes, scanf_fp.o(i._is_digit), UNUSED)

[Called By]

- >> _scanf_really_real

_normalizeAngle (Thumb, 74 bytes, Stack size 32 bytes, foc_utils.o(i._normalizeAngle))

[Stack]

- Max Depth = 136
- Call Chain = _normalizeAngle ⇒ fmod ⇒ _drem ⇒ _double_epilogue ⇒ _double_round

[Calls]

- >> fmod
- >> __aeabi_f2d
- >> __aeabi_dadd
- >> __aeabi_d2f
- >> __aeabi_cfrcmple

[Called By]

- >> setPhaseVoltage
- >> alignSensor
- >> electricalAngle

_sin (Thumb, 612 bytes, Stack size 56 bytes, foc_utils.o(i._sin))

[Stack]

- Max Depth = 144
- Call Chain = _sin ⇒ __aeabi_dsub ⇒ __aeabi_dadd ⇒ _double_epilogue ⇒ _double_round

[Calls]

- >> __aeabi_i2d
- >> __aeabi_f2d
- >> __aeabi_dsub
- >> __aeabi_dmul
- >> __aeabi_dadd
- >> __aeabi_d2iz
- >> __aeabi_d2f
- >> __aeabi_cdrcmple
- >> __aeabi_cdcmple

[Called By]

- >> setPhaseVoltage

_sqrtApprox (Thumb, 26 bytes, Stack size 16 bytes, foc_utils.o(i._sqrtApprox))

[Stack]

- Max Depth = 24
- Call Chain = _sqrtApprox ⇒ __aeabi_fmul

[Calls]

- >> __aeabi_fmul

[Called By]

- >> setPhaseVoltage

alignSensor (Thumb, 92 bytes, Stack size 24 bytes, bldcmotor.o(i.alignSensor))

[Stack]

- Max Depth = 344
- Call Chain = alignSensor ⇒ setPhaseVoltage ⇒ atan2 ⇒ atan ⇒ __kernel_poly ⇒ __aeabi_dmul ⇒ _double_epilogue ⇒ _double_round

[Calls]

- >> setPhaseVoltage
- >> getAngle
- >> __aeabi_i2f
- >> __aeabi_fmul
- >> _normalizeAngle
- >> _electricalAngle
- >> delay_ms

[Called By]

- >> Motor_initFOC

atan (Thumb, 474 bytes, Stack size 40 bytes, atan.o(i.atan))

[Stack]

- Max Depth = 152
- Call Chain = atan ⇒ __kernel_poly ⇒ __aeabi_dmul ⇒ _double_epilogue ⇒ _double_round

[Calls]

- >> __aeabi_drsub
- >> __aeabi_ddiv
- >> __aeabi_dsub
- >> __aeabi_dmul
- >> __aeabi_dadd
- >> __kernel_poly
- >> __ARM_fpclassify
- >> __mathlib_dbl_underflow
- >> __mathlib_dbl_infnan
- >> __ARM_scalbn

[Called By]

- >> atan2

atan2 (Thumb, 374 bytes, Stack size 32 bytes, atan2.o(i.atan2))

[Stack]

- Max Depth = 184
- Call Chain = atan2 ⇒ atan ⇒ __kernel_poly ⇒ __aeabi_dmul ⇒ _double_epilogue ⇒ _double_round

[Calls]

- >> __aeabi_drsub
- >> __aeabi_cdcmpeq
- >> __aeabi_ddiv
- >> __aeabi_dsub
- >> __set_errno
- >> __mathlib_dbl_infnan2
- >> atan

[Called By]

- >> setPhaseVoltage

atof (Thumb, 42 bytes, Stack size 24 bytes, atof.o(i.atof))

[Stack]

- Max Depth = 224
- Call Chain = atof ⇒ __strtod_int ⇒ _local_sscanf ⇒ _scanf_real

[Calls]

- >> __strtod_int
- >> __set_errno
- >> __read_errno

[Called By]

- >> commander_run

commander_run (Thumb, 156 bytes, Stack size 16 bytes, main.o(i.commander_run))

[Stack]

- Max Depth = 240
- Call Chain = commander_run ⇒ atof ⇒ __strtod_int ⇒ _local_sscanf ⇒ _scanf_real

[Calls]

- >> GPIO_SetBits
- >> GPIO_ResetBits
- >> __2printf
- >> atof
- >> shaftVelocity
- >> __aeabi_d2f
- >> uart_send_tx_s

[Called By]

- >> main

delay_ms (Thumb, 72 bytes, Stack size 0 bytes, delay.o(i.delay_ms))

[Called By]

- >> main
- >> alignSensor
- >> Motor_initFOC

electricalAngle (Thumb, 56 bytes, Stack size 24 bytes, focmotor.o(i.electricalAngle))

[Stack]

- Max Depth = 160
- Call Chain = electricalAngle ⇒ _normalizeAngle ⇒ fmod ⇒ _drem ⇒ _double_epilogue ⇒ _double_round

[Calls]

- >> __aeabi_fsub
- >> __aeabi_fadd
- >> __aeabi_i2f
- >> __aeabi_fmul
- >> _normalizeAngle

[Called By]

- >> loopFOC

fmod (Thumb, 144 bytes, Stack size 16 bytes, fmod.o(i.fmod))

[Stack]

- Max Depth = 104
- Call Chain = fmod ⇒ _drem ⇒ _double_epilogue ⇒ _double_round

[Calls]

- >> _drem
- >> __aeabi_drsub
- >> __set_errno
- >> __mathlib_dbl_invalid

[Called By]

- >> _normalizeAngle

fputc (Thumb, 24 bytes, Stack size 0 bytes, usart.o(i.fputc))
[Address Reference Count : 1]

- printfb.o(i.__0printf$bare)

getAngle (Thumb, 214 bytes, Stack size 56 bytes, magneticsensor.o(i.getAngle))

[Stack]

- Max Depth = 144
- Call Chain = getAngle ⇒ __aeabi_dmul ⇒ _double_epilogue ⇒ _double_round

[Calls]

- >> __aeabi_f2iz
- >> I2C_getRawCount
- >> __aeabi_frsub
- >> __aeabi_ui2f
- >> __aeabi_fdiv
- >> __aeabi_i2f
- >> __aeabi_i2d
- >> __aeabi_f2d
- >> __aeabi_dmul
- >> __aeabi_dadd
- >> __aeabi_d2f
- >> __aeabi_cfrcmple
- >> __aeabi_cdrcmple

[Called By]

- >> alignSensor
- >> Motor_initFOC
- >> getVelocity
- >> shaftAngle

getVelocity (Thumb, 180 bytes, Stack size 48 bytes, magneticsensor.o(i.getVelocity))

[Stack]

- Max Depth = 192
- Call Chain = getVelocity ⇒ getAngle ⇒ __aeabi_dmul ⇒ _double_epilogue ⇒ _double_round

[Calls]

- >> __aeabi_ui2f
- >> __aeabi_fdiv
- >> __aeabi_cfcmpeq
- >> getAngle
- >> __aeabi_fsub
- >> __aeabi_f2d
- >> __aeabi_dmul
- >> __aeabi_d2f
- >> __aeabi_cdrcmple

[Called By]

- >> shaftVelocity

loopFOC (Thumb, 54 bytes, Stack size 8 bytes, bldcmotor.o(i.loopFOC))

[Stack]

- Max Depth = 328
- Call Chain = loopFOC ⇒ setPhaseVoltage ⇒ atan2 ⇒ atan ⇒ __kernel_poly ⇒ __aeabi_dmul ⇒ _double_epilogue ⇒ _double_round

[Calls]

- >> setPhaseVoltage
- >> shaftAngle
- >> electricalAngle

[Called By]

- >> main

main (Thumb, 188 bytes, Stack size 0 bytes, main.o(i.main))

[Stack]

- Max Depth = 352
- Call Chain = main ⇒ Motor_initFOC ⇒ alignSensor ⇒ setPhaseVoltage ⇒ atan2 ⇒ atan ⇒ __kernel_poly ⇒ __aeabi_dmul ⇒ _double_epilogue ⇒ _double_round

[Calls]

- >> GPIO_SetBits
- >> commander_run
- >> GPIO_Config
- >> MagneticSensor_Init
- >> loopFOC
- >> Motor_initFOC
- >> Motor_init
- >> shaftVelocity
- >> I2C_Init_
- >> uart_send_tx_s
- >> uart_init
- >> systick_CountMode
- >> delay_ms
- >> TIM4_1ms_Init
- >> TIM2_PWM_Init

[Address Reference Count : 1]

- entry9a.o(.ARM.Collect$$$$0000000B)

setPhaseVoltage (Thumb, 1012 bytes, Stack size 136 bytes, bldcmotor.o(i.setPhaseVoltage))

[Stack]

- Max Depth = 320
- Call Chain = setPhaseVoltage ⇒ atan2 ⇒ atan ⇒ __kernel_poly ⇒ __aeabi_dmul ⇒ _double_epilogue ⇒ _double_round

[Calls]

- >> atan2
- >> __aeabi_ui2d
- >> __aeabi_fdiv
- >> __aeabi_f2uiz
- >> __aeabi_ddiv
- >> __aeabi_d2uiz
- >> __aeabi_cfcmpeq
- >> __aeabi_fsub
- >> __aeabi_fadd
- >> __aeabi_fmul
- >> __aeabi_f2d
- >> __aeabi_dsub
- >> __aeabi_dmul
- >> __aeabi_dadd
- >> __aeabi_d2f
- >> __aeabi_cdrcmple
- >> __aeabi_cdcmple
- >> _sqrtApprox
- >> _sin
- >> _normalizeAngle
- >> TIM_SetCompare3
- >> TIM_SetCompare2
- >> TIM_SetCompare1

[Called By]

- >> loopFOC
- >> alignSensor

shaftAngle (Thumb, 38 bytes, Stack size 16 bytes, focmotor.o(i.shaftAngle))

[Stack]

- Max Depth = 160
- Call Chain = shaftAngle ⇒ getAngle ⇒ __aeabi_dmul ⇒ _double_epilogue ⇒ _double_round

[Calls]

- >> getAngle
- >> __aeabi_fsub
- >> __aeabi_i2f
- >> __aeabi_fmul

[Called By]

- >> loopFOC
- >> Motor_initFOC

shaftVelocity (Thumb, 32 bytes, Stack size 16 bytes, focmotor.o(i.shaftVelocity))

[Stack]

- Max Depth = 208
- Call Chain = shaftVelocity ⇒ getVelocity ⇒ getAngle ⇒ __aeabi_dmul ⇒ _double_epilogue ⇒ _double_round

[Calls]

- >> getVelocity
- >> LPF_velocity
- >> __aeabi_i2f
- >> __aeabi_fmul

[Called By]

- >> main
- >> commander_run
- >> Motor_initFOC

systick_CountMode (Thumb, 18 bytes, Stack size 0 bytes, delay.o(i.systick_CountMode))

[Called By]

- >> main

uart_init (Thumb, 152 bytes, Stack size 32 bytes, usart.o(i.uart_init))

[Stack]

- Max Depth = 100
- Call Chain = uart_init ⇒ USART_Init ⇒ RCC_GetClocksFreq

[Calls]

- >> NVIC_Init
- >> GPIO_Init
- >> RCC_APB2PeriphClockCmd
- >> USART_Init
- >> USART_ITConfig
- >> USART_Cmd

[Called By]

- >> main

uart_send_tx (Thumb, 22 bytes, Stack size 0 bytes, usart.o(i.uart_send_tx))

[Called By]

- >> uart_send_tx_s

uart_send_tx_s (Thumb, 28 bytes, Stack size 8 bytes, usart.o(i.uart_send_tx_s))

[Stack]

- Max Depth = 8
- Call Chain = uart_send_tx_s

[Calls]

- >> uart_send_tx

[Called By]

- >> main
- >> commander_run

### Local Symbols

SetSysClock (Thumb, 8 bytes, Stack size 8 bytes, system_stm32f10x.o(i.SetSysClock))

[Stack]

- Max Depth = 20
- Call Chain = SetSysClock ⇒ SetSysClockTo72

[Calls]

- >> SetSysClockTo72

[Called By]

- >> SystemInit

SetSysClockTo72 (Thumb, 214 bytes, Stack size 12 bytes, system_stm32f10x.o(i.SetSysClockTo72))

[Stack]

- Max Depth = 12
- Call Chain = SetSysClockTo72

[Called By]

- >> SetSysClock

_printf_core (Thumb, 34 bytes, Stack size 24 bytes, printfb.o(i._printf_core), UNUSED)

[Called By]

- >> __0printf$bare

_local_sscanf (Thumb, 54 bytes, Stack size 56 bytes, strtod.o(.text))

[Stack]

- Max Depth = 160
- Call Chain = _local_sscanf ⇒ _scanf_real

[Calls]

- >> _scanf_real

[Called By]

- >> __strtod_int

_fp_value (Thumb, 296 bytes, Stack size 64 bytes, scanf_fp.o(.text), UNUSED)

[Calls]

- >> __aeabi_ddiv
- >> __aeabi_dmul
- >> __aeabi_ul2d

[Called By]

- >> _scanf_really_real

### Undefined Global Symbols
