ChenBaoW/Foot-wheel-robots/(list of files, drawings)

Other design files:
hardware/dcdc/ProProject_dc_to_dc_2024-05-25.epro
hardware/minifoc/ProProject_minifoc_test_4.0_2024-05-25.epro
