ChenBaoW/Foot-wheel-robots/software/MovingObject/Src/main.c

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
/* Includes ------------------------------------------------------------------*/
#include "main.h"
#include "dma.h"
#include "i2c.h"
#include "tim.h"
#include "usart.h"
#include "gpio.h"

/* USER CODE BEGIN Includes */
//#include "task.h"
#include "motor.h"
#include "pid.h"
#include "mpu6050.h"
#include "servo.h"
#include "telecontrols.h"
#include "filter.h"
#include <stdio.h>
#include <string.h>
#include <math.h>
/* USER CODE END Includes */


/* USER CODE BEGIN PV */
uint8_t status = 0;
/* USER CODE END PV */

void SystemClock_Config(void);
/* USER CODE BEGIN 0 */
int value = 0;
uint16_t left_value = 0;
uint16_t right_value = 0;
/* USER CODE END 0 */

/**
  * @brief  The application entry point.
  * @retval int
  */
int main(void)
{
  /* USER CODE BEGIN 1 */
 	int i = 0;
  /* USER CODE END 1 */

  /* MCU Configuration--------------------------------------------------------*/

  /* Reset of all peripherals, Initializes the Flash interface and the Systick. */
  HAL_Init();

  /* Configure the system clock */
  SystemClock_Config();

  /* Initialize all configured peripherals */
  MX_GPIO_Init();
  MX_DMA_Init();
  MX_USART1_UART_Init();
  MX_USART2_UART_Init();
  MX_TIM2_Init();
  MX_USART3_UART_Init();
  MX_I2C1_Init();
  MX_TIM3_Init();
  /* USER CODE BEGIN 2 */
	servo_init(&htim2, TIM_CHANNEL_1, &htim3, TIM_CHANNEL_1);
	set_pwm_value(1600, 1400);
	
	#if 0
	telecontrols_init();
	while(1){
			left_value = 1500 - (telecontrols.myData.x_data - 127) * 2;
			right_value = 1500 + (telecontrols.myData.x_data - 127) * 2;
			set_pwm_value(left_value, right_value);
			HAL_Delay(100);
	}
	#endif
	
	motor_init();
	telecontrols_init();
	
	while(w_mpu_init() != mpu_ok)
	{
		printf("0x%x (ID_ERROR)\r\n", w_mpu_init());
		HAL_Delay(500);
	}
	dmp_init();
  /* USER CODE END 2 */

  /* Infinite loop */
  /* USER CODE BEGIN WHILE */
  while (1)
  {
		if(status == 1){
			if(telecontrols.myData.sys_status == JUMP && telecontrols.myData.key_status == 1){
				servo_jump();
				telecontrols.myData.key_status = 0;
			}
			pid_handle();	
			if(telecontrols.myData.sys_status == RISER){
				value = ((int)telecontrols.myData.z_data - 127) * 2;
				left_value = 1600 - value;
				right_value = 1400 + value;
				set_pwm_value(left_value, right_value);
			}
			status = 0;
		}
    /* USER CODE END WHILE */

    /* USER CODE BEGIN 3 */
  }
  /* USER CODE END 3 */
}

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
