ChenBaoW/Foot-wheel-robots/software/MovingObject/MovingObject.ioc

Mcu.UserName=STM32F103C8Tx
PA0-WKUP.Signal=S_TIM2_CH1_ETR
PA10.Signal=USART1_RX
PA13.Signal=SYS_JTMS-SWDIO
PA14.Signal=SYS_JTCK-SWCLK
PA2.Signal=USART2_TX
PA3.Signal=USART2_RX
PA6.Signal=S_TIM3_CH1
PA9.Signal=USART1_TX
PB10.Signal=USART3_TX
PB11.Signal=USART3_RX
PB5.GPIO_Label=MPU_INT
PB5.Signal=GPXTI5
PB6.Signal=I2C1_SCL
PB7.Signal=I2C1_SDA
PC14-OSC32_IN.Signal=RCC_OSC32_IN
PC15-OSC32_OUT.Signal=RCC_OSC32_OUT
PD0-OSC_IN.Signal=RCC_OSC_IN
PD1-OSC_OUT.Signal=RCC_OSC_OUT
