ChenBaoW/Foot-wheel-robots/(commit log)

2024-07-05 初次提交内容有机器人的硬件设计部分和机械结构部分
    硬件结构有DCDC电池管理模块和FOC驱动板模块
    机械结构有机器人主体和腿部结构
    由于硬件和机械结构的制作需要花的时间较多，前期先开源这两个部分
    [ProProject_dc_to_dc_2024-05-25.epro, ProProject_minifoc_test_4.0_2024-05-25.epro, 前支撑(带电池夹) .step, 前支撑(带电池夹)_.f3d, 副腿.f3d, 副腿.step, 右小腿.f3d, 右小腿.step]
2024-07-09 补充硬件讲解和机械讲解
    [前支撑(带电池夹) .step, 前支撑(带电池夹)_.f3d, 副腿.f3d, 副腿.step, 右小腿.f3d, 右小腿.step, 后支撑.f3d, 后支撑.ipt]
2024-07-10 上传手柄摇杆控制程序（ESP32版），可以根据协议内容更换无线控制方式（如蓝牙）
2024-07-14 软件代码
    4_closeloop_M1_test：FOC软件
    MovingObject：主控软件
